jvduuren/ziggo-harmony/extras/case/ziggo-harmony-pipe-2.9.stl

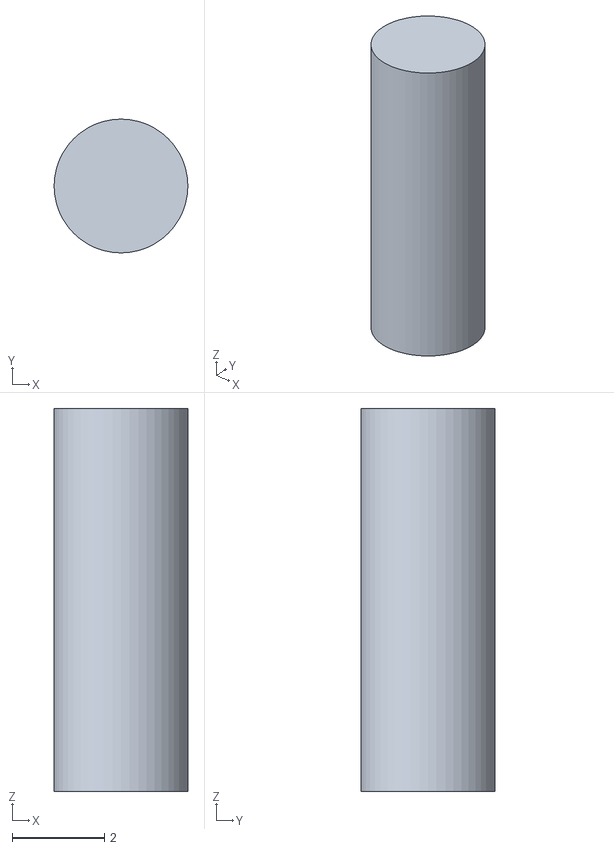
[picture p2: CAD file, 2026-10-16]
extras/case/ziggo-harmony-pipe-2.9.stl
2.90 x 2.90 x 8.30
