jvduuren/ziggo-harmony/extras/case/ziggo-harmony-base.stl

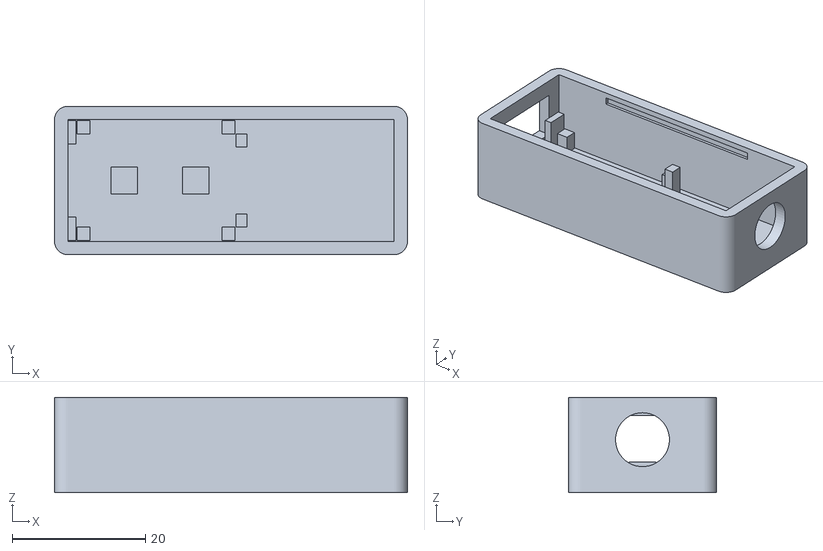
[picture p3: CAD file, 2026-10-16]
extras/case/ziggo-harmony-base.stl
53.0 x 22.3 x 14.3
