jvduuren/ziggo-harmony/extras/case/ziggo-harmony-pipe-2.6.stl

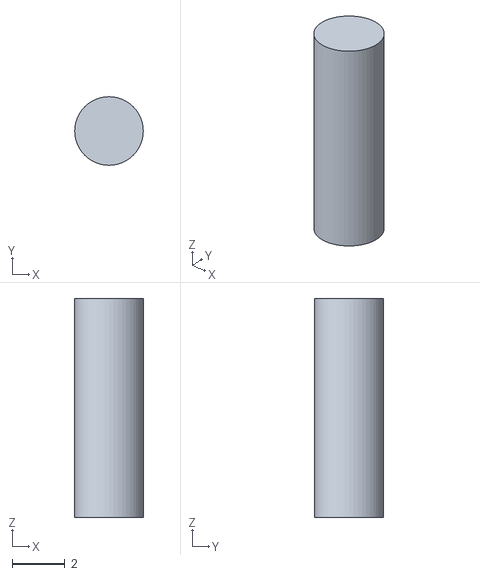
[picture p4: CAD file, 2026-10-16]
extras/case/ziggo-harmony-pipe-2.6.stl
2.60 x 2.60 x 8.30
