jvduuren/ziggo-harmony/extras/case/ziggo-harmony-pipe-2.8.stl

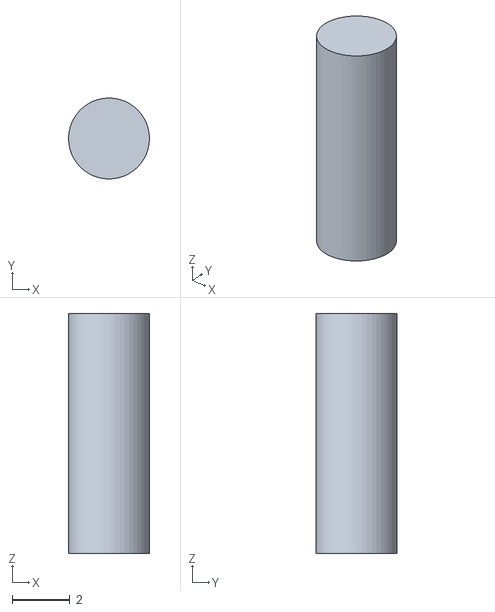
[picture p5: CAD file, 2026-10-16]
extras/case/ziggo-harmony-pipe-2.8.stl
2.80 x 2.80 x 8.30
