jvduuren/ziggo-harmony/extras/case/ziggo-harmony-pipe-2.7.stl

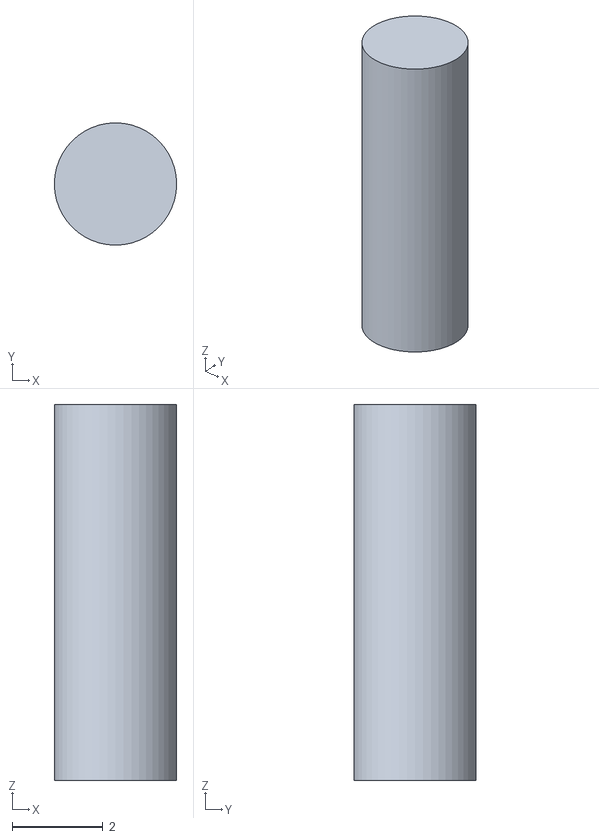
[picture p6: CAD file, 2026-10-16]
extras/case/ziggo-harmony-pipe-2.7.stl
2.70 x 2.70 x 8.30
