jvduuren/ziggo-harmony/extras/case/ziggo-harmony-lid.stl

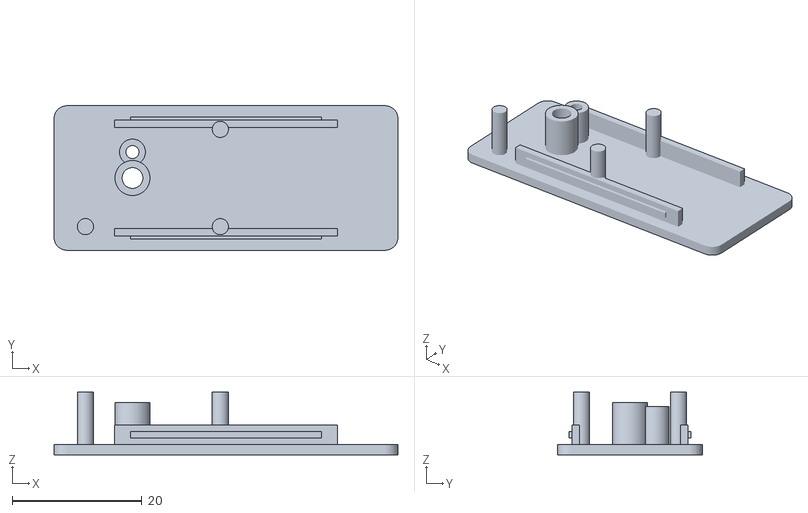
[picture p7: CAD file, 2026-10-16]
extras/case/ziggo-harmony-lid.stl
53.0 x 22.3 x 9.70
