jvduuren/ziggo-harmony/extras/case/ziggo-harmony-case.3mf

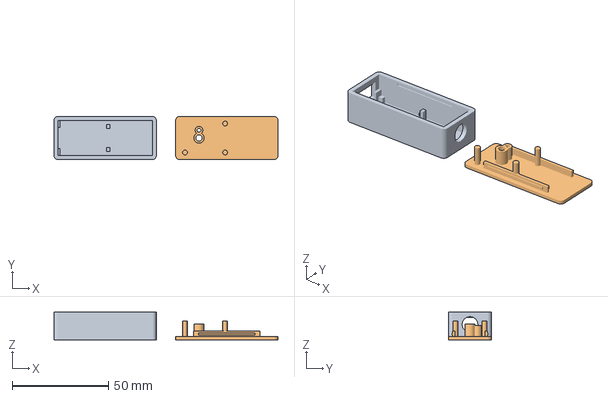
[picture p8: CAD file, 2026-10-16]
extras/case/ziggo-harmony-case.3mf
116.1 x 22.3 x 14.3 mm
onderbak
deksel
