jvduuren/ziggo-harmony/extras/case/ziggo-harmony-light-pipe.3mf

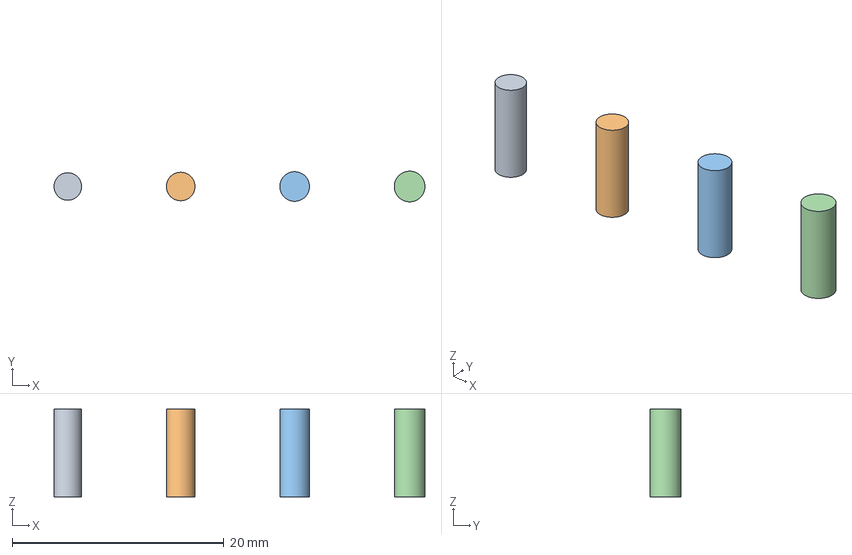
[picture p9: CAD file, 2026-10-16]
extras/case/ziggo-harmony-light-pipe.3mf
35.0 x 2.90 x 8.30 mm
lichtgeleider 2,6 mm
lichtgeleider 2,7 mm
lichtgeleider 2,8 mm
lichtgeleider 2,9 mm
