jvduuren/ziggo-harmony/src/ble_remote.h

#pragma once

#include <Arduino.h>

// BLE HID peripheral that presents itself exactly like the original
// Ziggo Next Mini remote (UEI "RemoteUnit").
namespace ble {

void begin();
bool connected();
bool ready();  // connected, encrypted and the box subscribed to key reports
void press(uint8_t report, uint16_t usage);
void release(uint8_t report);
void unpair();  // forget all bonds; the box can pair again
int bondCount();
String ownAddress();
String peerAddress();
const char* stateText();
String boxMessages();  // recent writes from the box (vendor report 8, HID control point)
// Log the raw advertisements of nearby HID / UEI remotes, e.g. the original remote in
// pairing mode, to compare them with our own.
void scan(uint32_t seconds);

}  // namespace ble
