jvduuren/ziggo-harmony/(commit log)

2026-10-09 Firmware v0.1.0 en projectopzet voor de community
    - ESP32-S3-firmware (PlatformIO): BLE HID-peripheral die zich voordoet als de
    originele UEI-afstandsbediening, IR-ontvangst met leermodus, webinterface,
    HTTP-API, seriele console, firmware-update via web
    - Doelen: Waveshare ESP32-S3-Zero en Seeed XIAO ESP32S3
    - README in Engels en Nederlands, MIT-licentie, BLE-profiel als Engelse referentie
    - GitHub Actions bouwt beide boards
    - HA-cloudroute verplaatst naar extras/, plus lokaal rest_command-voorbeeld
2026-10-09 factory.bin voor flashen via de browser, log via webinterface
    - Post-build script maakt factory.bin (alles-in-een, offset 0x0) voor esptool-js
    - Logregels ook bewaard in een ringbuffer: /api/log en sectie Log in de webinterface,
    zodat de brug zonder USB te volgen is
    - CI bewaart factory.bin en firmware.bin; README's beschrijven flashen via browser
    en updates via wifi (curl)
2026-10-11 v0.2.0: werkt op hardware met Harmony Smart Control en Next Mini
    - Advertentie byte voor byte gelijk aan de originele remote in koppelmodus
    (flags limited discoverable, appearance remote control, scan response);
    zonder dat negeert het koppelscherm van de box de brug
    - Standby stuurt Consumer Power (0x0030); 0x003F wordt door de box genegeerd
    - Maximaal 3 IR-codes per knop (bijv. Play en Pause), oude mapping blijft geldig
    - Leren slaat niet-decodeerbare (UNKNOWN) codes over
    - Scan-commando en /api/scan om advertenties van remotes uit te lezen
    - Kant-en-klare mapping voor het Harmony-apparaat Windows Media Center
    - README (EN/NL) bijgewerkt: Media-pc-instructies, mDNS, beperkingen
    - CI maa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
2026-10-16 Interne pull-up op de IR-pin voor kant-en-klare IR-oogjes
    Een IR-verlengkabel met oogje (getest: Amazon B07KM1Q48Y) heeft een open-collector-uitgang
    zonder eigen pull-up. Zonder pull-up kwam hooguit af en toe een code door; met de interne
    pull-up van GPIO1 komt elke druk compleet binnen. Losse ontvangers zoals de VS1838B hebben
    zelf een pull-up en merken er niets van.
    README (EN/NL): ontvanger aan een kabel, pinout doormeten met een multimeter.
2026-10-16 v0.2.1: korte IR-druk wordt een korte tik naar de box
    Een Harmony-druk (3 RC6-frames, ~0,2 s) plus de release-timeout hield de toets ~0,41 s vast.
    De box begint dan al met automatisch herhalen, waardoor links/rechts twee stappen gingen
    en drie snelle drukken vier of vijf werden. Nu krijgt de box per IR-druk een tik van 80 ms;
    alleen als de IR-frames langer dan 0,5 s doorkomen, wordt de toets opnieuw ingedrukt en
    vastgehouden, zodat doorscrollen blijft werken.
2026-10-16 Kastje: parametrisch OpenSCAD-ontwerp, eerste versie
    Onderbak voor de Waveshare ESP32-S3-Zero met een opening voor de USB-C-stekker en een gat
    voor een 3,5 mm-inbouwbus (externe IR-ontvanger), steuntjes onder het midden van het bordje
    (de randcontacten hebben soldeerpunten aan de onderkant) en aanslagjes erachter. Klikdeksel
    met een lichtgeleider boven de led en een pin-gaatje voor BOOT. Maten zijn opgemeten aan
    het eigen bordje; de STL's zijn gegenereerd uit het .scad-bestand. Nog niet proefgeprint.
    [ziggo-harmony-base.stl, ziggo-harmony-case.scad, ziggo-harmony-lid.stl, ziggo-harmony-pipe.stl]
2026-10-16 Kastje: Bambu Studio-projecten (.3mf)
    ziggo-harmony-case.3mf (onderbak + deksel, 0,20 mm, 3 wanden) en
    ziggo-harmony-light-pipe.3mf (4 lichtgeleiders, 0,12 mm, massief, brim) voor Bambu Lab A1
    met Bambu PLA Basic. make_3mf.py bouwt ze uit de STL's en doet een printcontrole.
    [ziggo-harmony-case.3mf, ziggo-harmony-light-pipe.3mf]
2026-10-16 Kastje v2: bordje zit vast in alle richtingen
    Na een proefpassing zat het bordje los in alle richtingen, ook met het deksel erop.
    - steuntjes onder de vier hoeken (kantelde op de twee middelste steuntjes)
    - aanslagjes aan de USB-kant naast de USB-C-aansluiting: die is kleiner dan de
    stekkeropening, waardoor het bordje de opening in kon schuiven
    - speling rond het bordje 0,15 mm in plaats van 0,4 mm
    - drie pennetjes onder het deksel drukken het bordje bij de hoeken omlaag (niet bij de
    USB-hoek met de draadjes)
    [ziggo-harmony-base.stl, ziggo-harmony-case.3mf, ziggo-harmony-case.scad, ziggo-harmony-lid.stl, ziggo-harmony-light-pipe.3mf]
2026-10-16 Kastje: geleidebuisje voor de paperclip naar de BOOT-knop
    Het buisje (2 mm binnenmaat) loopt van het deksel tot 0,5 mm boven de BOOT-knop, zodat je
    niet naast de knop of op RESET kunt drukken.
    [ziggo-harmony-base.stl, ziggo-harmony-case.3mf, ziggo-harmony-case.scad, ziggo-harmony-lid.stl, ziggo-harmony-light-pipe.3mf]
2026-10-16 Kastje: BOOT-knop op 9 mm van de USB-kant (nagemeten)
    [ziggo-harmony-base.stl, ziggo-harmony-case.3mf, ziggo-harmony-case.scad, ziggo-harmony-lid.stl, ziggo-harmony-light-pipe.3mf]
2026-10-16 Kastje: led en BOOT-knop op één lijn, 8,75 mm van de USB-kant
    [ziggo-harmony-base.stl, ziggo-harmony-case.3mf, ziggo-harmony-case.scad, ziggo-harmony-lid.stl, ziggo-harmony-light-pipe.3mf]
2026-10-16 Kastje: printplaatlengte 23,8 mm (nagemeten met schuifmaat)
    [ziggo-harmony-base.stl, ziggo-harmony-case.3mf, ziggo-harmony-case.scad, ziggo-harmony-lid.stl, ziggo-harmony-light-pipe.3mf]
2026-10-16 Kastje: USB-C steekt 1,2 mm uit (totaal 25 mm, nagemeten)
    [ziggo-harmony-base.stl, ziggo-harmony-case.3mf, ziggo-harmony-case.scad, ziggo-harmony-lid.stl, ziggo-harmony-light-pipe.3mf]
2026-10-16 README: kastje en jackbus bij de benodigdheden
    Het kastje (extras/case) is getest: het bordje zit vast en alles past.
2026-10-16 Kastje: lichtgeleiders in vier diktes (2,6-2,9 mm)
    Het gat voor de lichtgeleider (3,2 mm getekend) kwam bij de proefprint uit op 3,0 mm. Het
    light-pipe-project bevat nu vier diktes, zodat je de staaf kiest die het best klemt.
    [ziggo-harmony-base.stl, ziggo-harmony-case.3mf, ziggo-harmony-case.scad, ziggo-harmony-lid.stl, ziggo-harmony-light-pipe.3mf, ziggo-harmony-pipe-2.6.stl, ziggo-harmony-pipe-2.7.stl, ziggo-harmony-pipe-2.8.stl]
2026-10-16 README: lichtgeleider van 2,8 mm past op een Bambu Lab A1
2026-10-17 v0.2.2: tik van 150 ms in plaats van 80 ms
    In de menu's van de box werd Back soms genegeerd, terwijl elke druk wel doorgestuurd werd.
    Met een tik van 150 ms reageert de box steeds; dat blijft ruim onder de ~0,4 s waarop de box
    zelf gaat herhalen, dus de dubbele stappen komen niet terug.
2026-10-17 README: foto van de brug in het kastje
    Foto zonder metadata, verkleind naar 900 x 1200.
2026-10-17 README: rode aan-led van het IR-oogje kan eraf
    Getest: na het desolderen van de led werkt de ontvanger gewoon door.
